WB2CBA/ADX-POCKET/ADX POCKET SCHEMATIC and PCB Layouts/ADX POCKET RF PCB COMPONENT LAYOUT.jpg

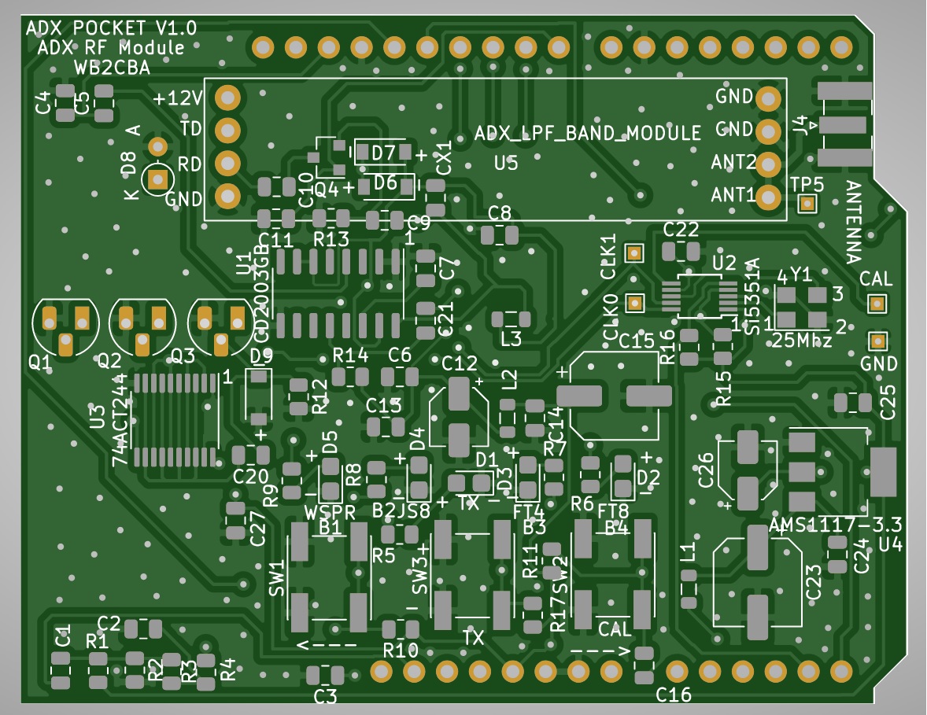
ADX POCKET SCHEMATIC and PCB Layouts/ADX POCKET RF PCB COMPONENT LAYOUT.jpg
