WB2CBA/ADX-POCKET/ADX POCKET SCHEMATIC and PCB Layouts/ADX POCKET CONTROLLER PCB COMPONENT SIDE LAYOUT.jpg

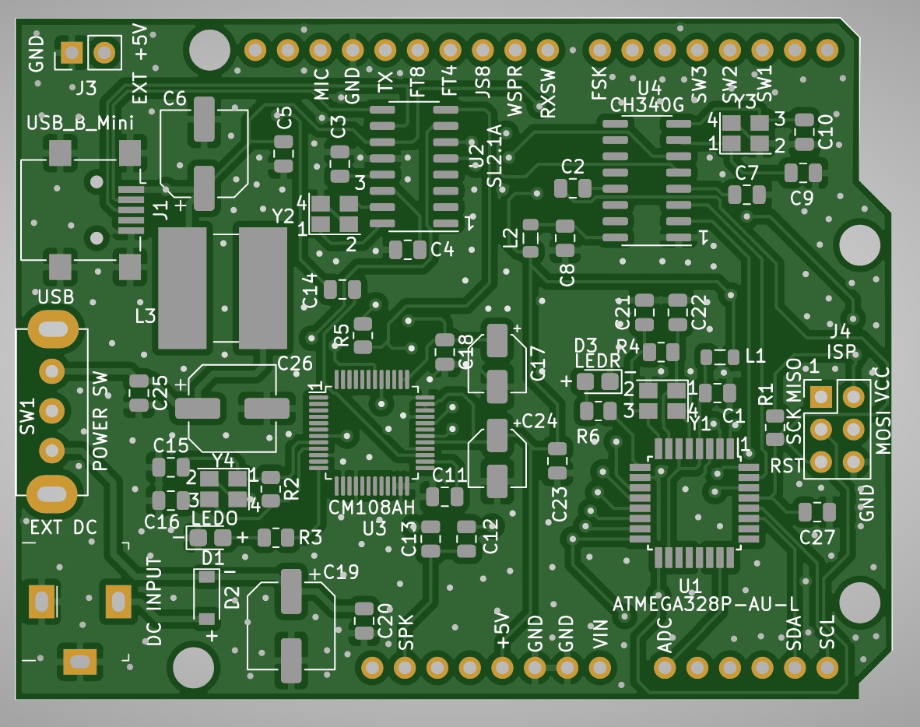
ADX POCKET SCHEMATIC and PCB Layouts/ADX POCKET CONTROLLER PCB COMPONENT SIDE LAYOUT.jpg
