WB2CBA/ADX-POCKET/ADX POCKET SCHEMATIC and PCB Layouts/ADX POCKET BOTTOM PLATE.jpg

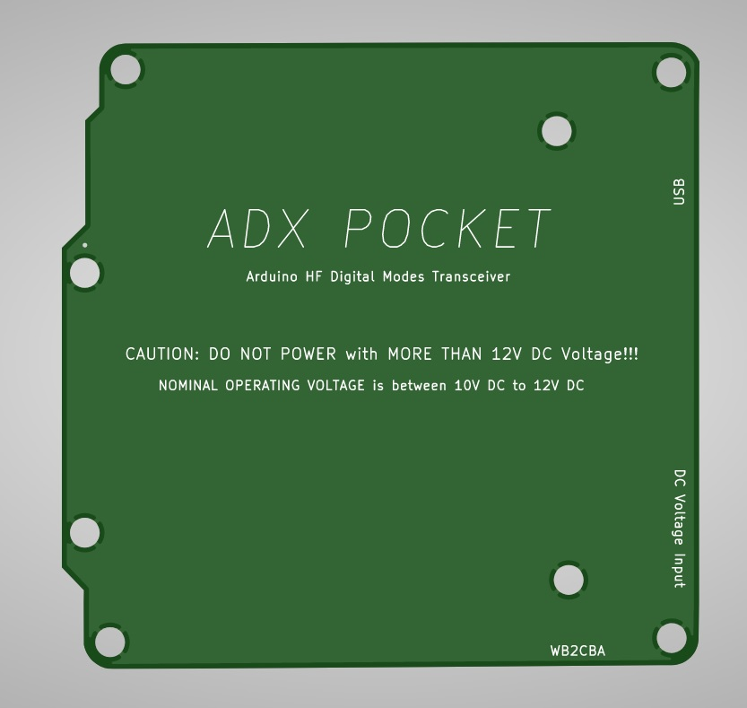
ADX POCKET SCHEMATIC and PCB Layouts/ADX POCKET BOTTOM PLATE.jpg
