WB2CBA/ADX-POCKET/ADX POCKET SCHEMATIC and PCB Layouts/ADX POCKET TOP PLATE.jpg

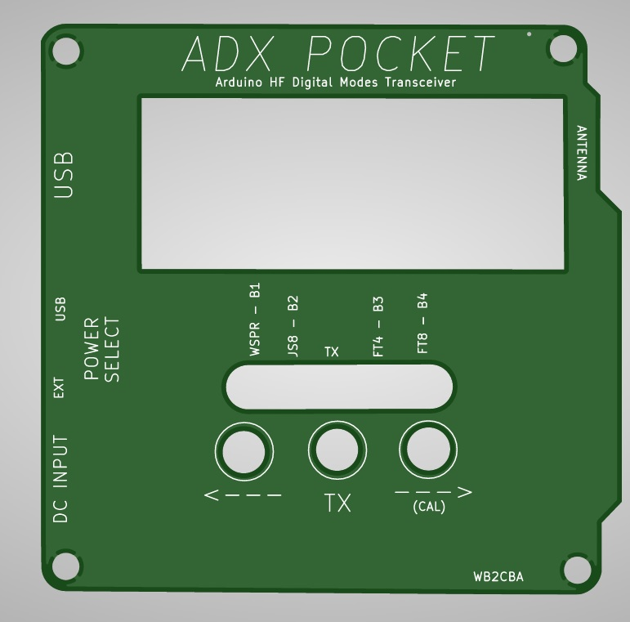
ADX POCKET SCHEMATIC and PCB Layouts/ADX POCKET TOP PLATE.jpg
