WB2CBA/ADX-POCKET/ADX POCKET SCHEMATIC and PCB Layouts/ADX POCKET CONTROLLER BOARD SCHEMATIC.pdf

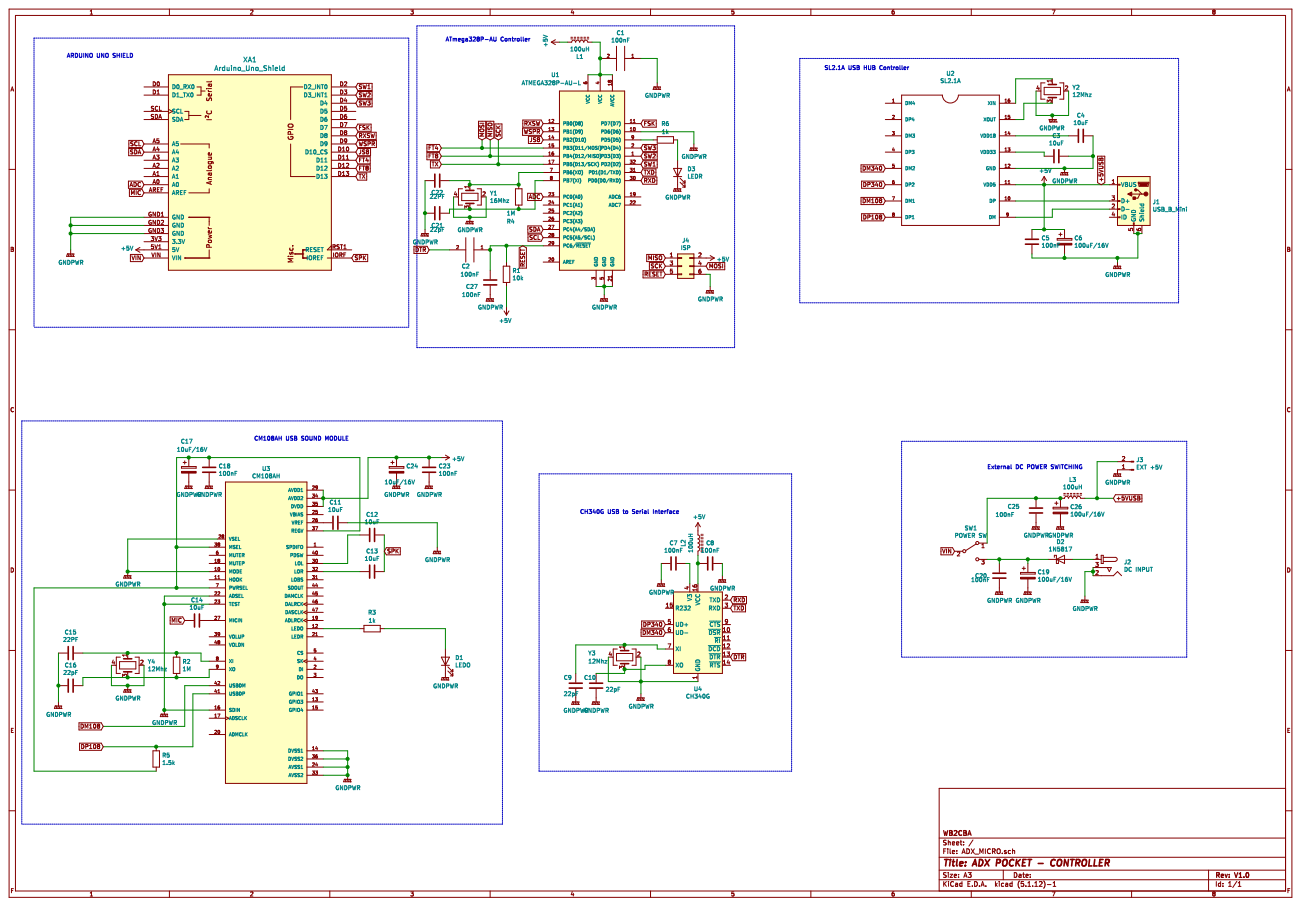
[picture p5: page 1]
