WB2CBA/ADX-POCKET/ADX POCKET SCHEMATIC and PCB Layouts/ADX POCKET RF Transceiver BOARD SCHEMATIC.pdf

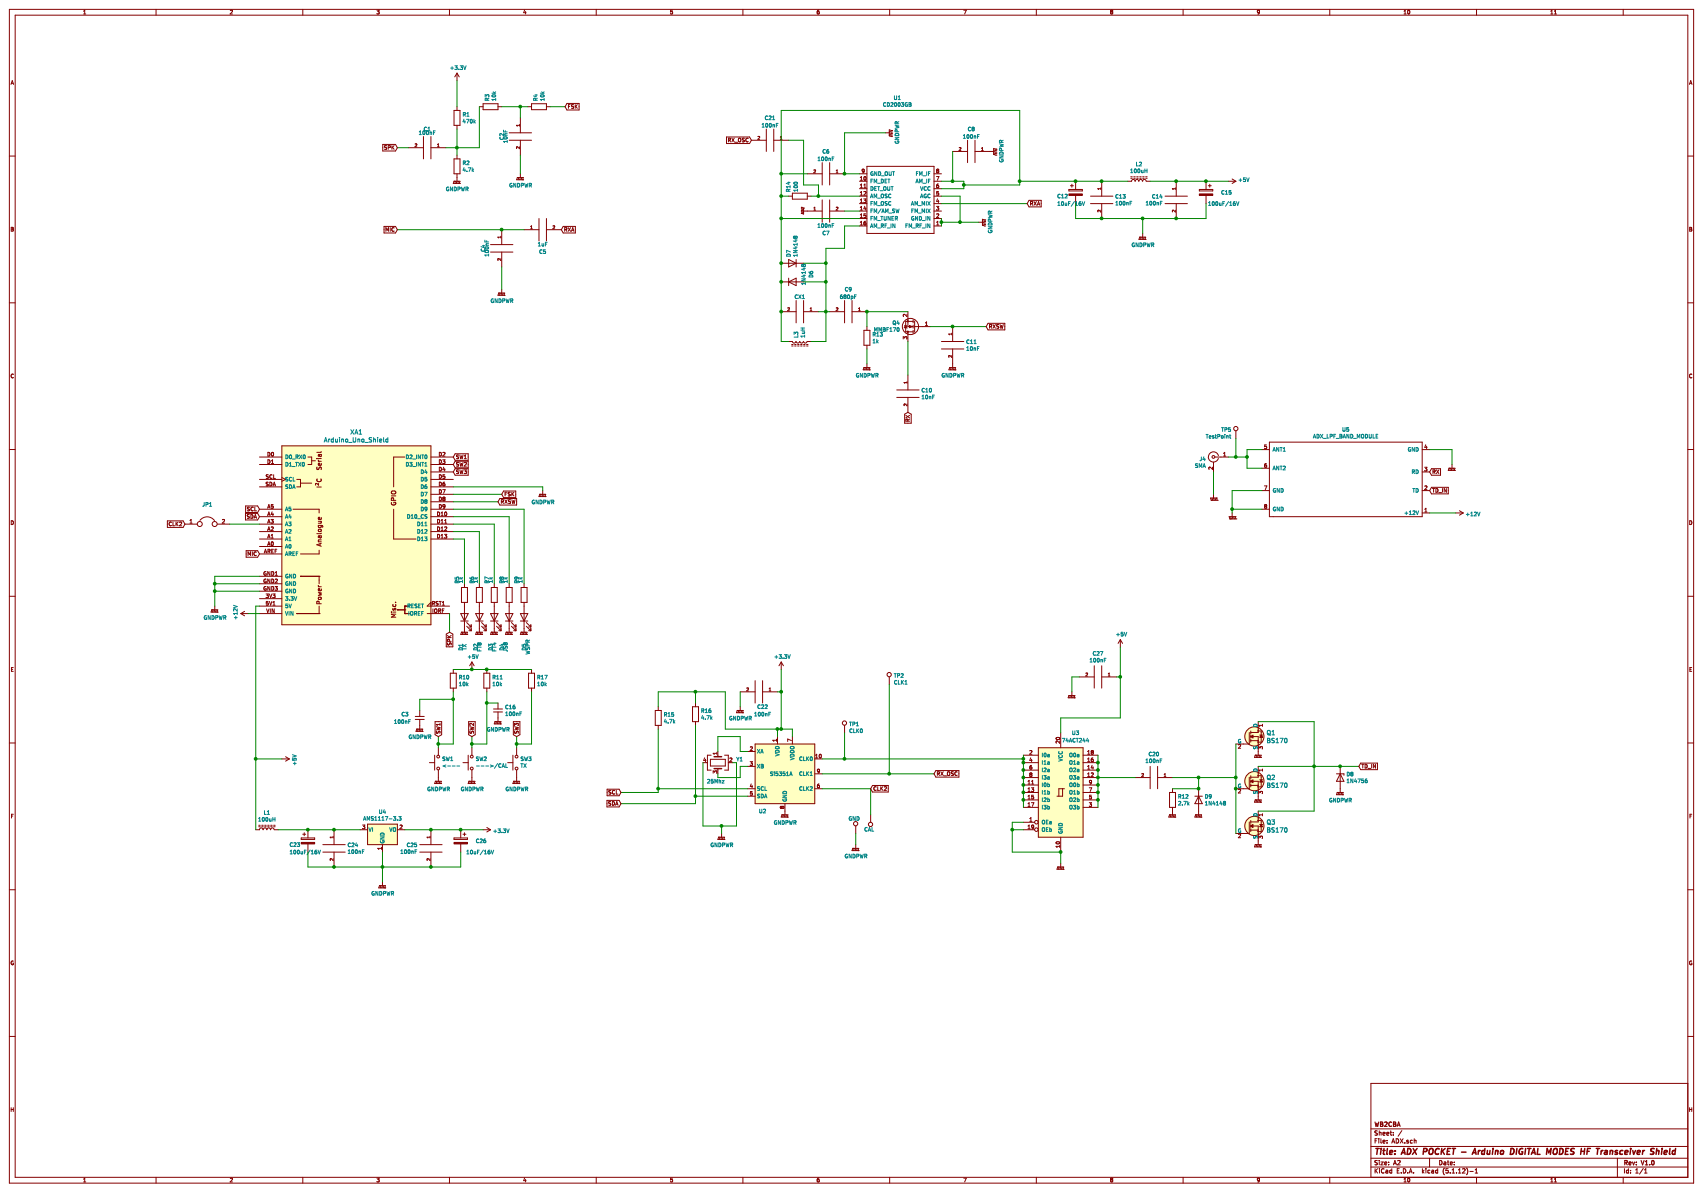
[picture p6: page 1]
