WB2CBA/ADX-POCKET/ADX POCKET FIRMWARE/ADX_POCKET_V1.0.ino

//*********************************************************************************************************
//******************* ADX POCKET - ARDUINO DIGITAL MODES HF TRANSCEIVER WITH CAT CONTROL  ***********************
//********************************* Write up start: 02/01/2022 ********************************************
// FW VERSION: ADX_POCKET_V1.0 - Version release date: 06/26/2023
// Barb(Barbaros ASUROGLU) - WB2CBA - 2022
//*********************************************************************************************************
// Required Libraries
// ----------------------------------------------------------------------------------------------------------------------
// Etherkit Si5351 (Needs to be installed via Library Manager to arduino ide) - SI5351 Library by Jason Mildrum (NT7S) - https://github.com/etherkit/Si5351Arduino
//*****************************************************************************************************
//* IMPORTANT NOTE: Use V2.1.3 of NT7S SI5351 Library. This is the only version compatible with ADX!!!*
//*****************************************************************************************************
// Arduino "Wire.h" I2C library(built-into arduino ide)
// Arduino "EEPROM.h" EEPROM Library(built-into arduino ide)
//*************************************[ LICENCE and CREDITS ]*********************************************
//  Initial FSK TX Signal Generation code by: Burkhard Kainka(DK7JD) - http://elektronik-labor.de/HF/SDRtxFSK2.html
//  SI5351 Library by Jason Mildrum (NT7S) - https://github.com/etherkit/Si5351Arduino
//  ADX CAT code inspired from Lajos Höss, HA8HL TS2000 CAT implementation for Arduino.
//  Improved FSK TX  signal generation code is from JE1RAV https://github.com/je1rav/QP-7C
//
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
//*****************[ SI5351 VFO CALIBRATION PROCEDURE ]****************************************
// For SI5351 VFO Calibration Procedure follow these steps:
// 1 - Connect CAL test point and GND test point on ADX PCB to a Frequency meter or Scope that can measure 1 Mhz up to 1Hz accurately.
// 2 - Press SW2 / --->(CAL) pushbutton and hold.
// 4-  Power up with 12V or with 5V by using arduino USB socket while still pressing SW2 / --->(CAL) pushbutton. 
// 5 - FT8 and WSPR LEDs will flash 3 times and stay lit. Now Release SW2 / --->(CAL). Now Calibration mode is active.
// 6 - Using SW1(<---) and SW2(--->) pushbuttons change the Calibration frequency.
// 7 - Try to read 1 Mhz = 1000000 Hz exact on  Frequency counter or Oscilloscope. 
//     The waveform is Square wave so freqency calculation can be performed esaily.
// 8 - If you read as accurate as possible 1000000 Hz then calibration is done. 
// 9 - Now we must save this calibration value to EEPROM location. 
//     In order to save calibration value, press TX button briefly. TX LED will flash 3 times which indicates that Calibration value is saved.
// 10- Power off ADX.
//
//
//********************************[ CAT CONTROL SETTINGS and CAT Functionality ]********************
// CAT CONTROL RIG EMULATION: KENWOOD TS2000
// SERIAL PORT SETTINGS: 115200 baud,8 bit,1 stop bit
// When CAT is active FT4 and JS8 leds will be solid lit.
// In CAT mode none of the Switches and leds are active including TX SWITCH in order to avoid different setting clashes except TX LED. 
// TX LED WILL BE LIT briefly on/off and then solid during TX WHEN TRANSMITTING IN CAT Mode.
// In CAT mode ADX can be controlled ONLY by CAT interface. Frequency and TX can be controlled via CAT.
// To get out of CAT mode and to use ADX with Switch and led interface just recycle power. Once activated CAT mode stays active as rig control Until power recycle. 
// In CAT mode manual Band setup is deactivated and ADX can be operated on any band as long as the right lpf filter module is plugged in. 
// IN CAT MODE MAKE SURE THE CORRECT LPF MODULE IS PLUGGED IN WHEN OPERATING BAND IS CHANGED!!! IF WRONG LPF FILTER MODULE IS PLUGGED IN then PA POWER MOSFETS CAN BE DAMAGED!
  
//*******************************[ LIBRARIES ]*************************************************
#include <si5351.h>
#include "Wire.h"
#include <EEPROM.h>
//*******************************[ VARIABLE DECLERATIONS ]*************************************
uint32_t val;
int temp;
uint32_t val_EE; 
int addr = 0;
int mode;
//unsigned long freq; 
unsigned long int freq1;
unsigned long int freq =  14074000;
int32_t cal_factor;
int TX_State = 0;

unsigned long Cal_freq = 1000000UL; // Calibration Frequency: 1 Mhz = 1000000 Hz
unsigned long F_FT8;
unsigned long F_FT4; 
unsigned long F_JS8;
unsigned long F_WSPR;
int Band_slot;
int Band = 0;
int UP_State;
int DOWN_State;
int TXSW_State;
int Bdly = 250;

//------------ CAT Variables
int cat_stat = 0;
int CAT_mode = 2;   
String received;
String receivedPart1;
String receivedPart2;    
String command;
String command2;  
String parameter;
String parameter2; 
String sent;
String sent2;
int TxStatus = 0; //0 =  RX 1=TX

// **********************************[ DEFINE's ]***********************************************
#define UP 2    // UP Switch
#define DOWN 3  // DOWN Switch
#define TXSW 4  // TX Switch

#define TX 13 //TX LED
#define WSPR  9 //WSPR LED 
#define JS8  10 //JS8 LED
#define FT4  11 //FT4 LED
#define FT8 12 //FT8 LED
#define RX  8 // RX SWITCH
#define SI5351_REF 		25000000UL  //change this to the frequency of the crystal on your si5351’s PCB, usually 25 or 27 MHz

//**********************************[ BAND SELECT ]************************************************
// ADX can support up to 4 bands on board. Those 4 bands needs to be assigned to Band1 ... Band4 from supported 8 bands.
// To change bands press SW1 and SW2 simultaneously. Band LED will flash 3 times briefly and stay lit for the stored band. also TX LED will be lit to indicate
// that Band select mode is active. Now change band bank by pressing SW1(<---) or SW2(--->). When desired band bank is selected press TX button briefly to exit band select mode. 
// Now the new selected band bank will flash 3 times and then stored mode LED will be lit. 
// TX won't activate when changing bands so don't worry on pressing TX button when changing bands in band mode.

// Assign your prefered bands to B1,B2,B3 and B4
// Supported Bands are: 80m, 40m, 30m, 20m,17m, 15m, 10m

int Band1 = 40; // Band 1 // These are default bands. Feel free to swap with yours
int Band2 = 30; // Band 2
int Band3 = 20; // Band 3
int Band4 = 17; // Band 4

//********************************[ CAT CONTROL VARIABLES ] **********************************************



Si5351 si5351;

//*************************************[ SETUP FUNCTION ]************************************** 
void setup()
{
   cat_stat = 0;
   pinMode(UP, INPUT);
   pinMode(DOWN, INPUT);
   pinMode(TXSW, INPUT);
   
pinMode(TX, OUTPUT);
pinMode(WSPR, OUTPUT);
pinMode(JS8, OUTPUT);
pinMode(FT4, OUTPUT);
pinMode(FT8, OUTPUT);
pinMode(RX, OUTPUT);

//pinMode(PTT,OUTPUT); // for CAT CONTROL

pinMode(7, INPUT); //PD7 = AN1 = HiZ, PD6 = AN0 = 0

//SET UP SERIAL FOR CAT CONTROL

Serial.begin(9600); 
Serial.setTimeout(4); 
  
INIT();

//------------------------------- SET SI5351 VFO -----------------------------------  
   // The crystal load value needs to match in order to have an accurate calibration
  si5351.init(SI5351_CRYSTAL_LOAD_8PF, 0, 0);
  si5351.set_correction(cal_factor, SI5351_PLL_INPUT_XO);
 si5351.set_pll(SI5351_PLL_FIXED, SI5351_PLLA);
  si5351.drive_strength(SI5351_CLK0, SI5351_DRIVE_8MA);// SET For Max Power
  si5351.drive_strength(SI5351_CLK1, SI5351_DRIVE_2MA); // Set for reduced power for RX 
  
 if ( digitalRead(DOWN) == LOW ) {
Calibration();
 }
 

  TCCR1A = 0x00;
  TCCR1B = 0x01; // Timer1 Timer 16 MHz
  TCCR1B = 0x81; // Timer1 Input Capture Noise Canceller
  ACSR |= (1<<ACIC);  // Analog Comparator Capture Input
  
  pinMode(7, INPUT); //PD7 = AN1 = HiZ, PD6 = AN0 = 0
          digitalWrite(RX,LOW);

 Mode_assign(); 

}
 
//**************************[ END OF SETUP FUNCTION ]************************

//***************************[ Main LOOP Function ]**************************
void loop()
{  

// CAT CHECK SERIAL FOR NEW DATA FROM WSJT-X AND RESPOND TO QUERIES

  
  if (Serial.available() > 0){
   cat_stat = 1; 
        si5351.set_freq(freq * 100ULL, SI5351_CLK1);
        si5351.output_enable(SI5351_CLK1, 1);   //RX on
        digitalWrite(WSPR, LOW); 
             digitalWrite(JS8, HIGH); 
                 digitalWrite(FT4, HIGH); 
                     digitalWrite(FT8, LOW); 
                     
       CAT_control(); 
     
    
  }

       UP_State = digitalRead(UP);
          DOWN_State = digitalRead(DOWN);


if ((UP_State == LOW)&&(DOWN_State == LOW)&&(TX_State == 0)&&(cat_stat == 0)) {
   delay(100); 
 UP_State = digitalRead(UP);
    DOWN_State = digitalRead(DOWN);
if ((UP_State == LOW)&&(DOWN_State == LOW)&&(TX_State == 0)&&(cat_stat == 0)) {

    Band_Select();
    
  }
}

  

if ((UP_State == LOW)&&(DOWN_State == HIGH)&&(TX_State == 0)&&(cat_stat == 0)) {
   delay(50); 
     
UP_State = digitalRead(UP);
if ((UP_State == LOW)&&(DOWN_State == HIGH)&&(TX_State == 0)&&(cat_stat == 0)) {
mode = mode - 1;

if (mode < 1){
mode = 4;
}



addr = 40;
 EEPROM.put(addr, mode); 
                Mode_assign();
                
  }} 
   
      DOWN_State = digitalRead(DOWN);

if ((UP_State == HIGH) && (DOWN_State == LOW)&&(TX_State == 0)&&(cat_stat == 0)) {
   delay(50); 
     
DOWN_State = digitalRead(DOWN);
if ((UP_State == HIGH) && (DOWN_State == LOW)&&(TX_State == 0)&&(cat_stat == 0)) {
mode = mode + 1;

if (mode > 4){
mode = 1;
}



addr = 40;
 EEPROM.put(addr, mode); 
                    Mode_assign();
                    
  }} 

  TXSW_State = digitalRead(TXSW);

if ((TXSW_State == LOW) && (TX_State == 0)&&(cat_stat == 0)) {
   delay(50); 
     
TXSW_State = digitalRead(TXSW);
if ((TXSW_State == LOW) && (TX_State == 0)&&(cat_stat == 0)) {
  
Mode_assign();

ManualTX();

           }
  
     }
  
 unsigned int d1,d2;
 int FSK = 10;
 int FSKtx = 0;
 while (FSK>0){
  TCNT1 = 0;
  while (ACSR &(1<<ACO)){
    if (TCNT1>65000) {break;
  }
  }  while ((ACSR &(1<<ACO))==0){
    if (TCNT1>65000) {break;}
  }
  TCNT1 = 0;
  while (ACSR &(1<<ACO)){
    if (TCNT1>65000) {break;}
  }
  d1 = ICR1;  
  while ((ACSR &(1<<ACO))==0){
    if (TCNT1>65000) {break;}
  } 
  while (ACSR &(1<<ACO)){
    if (TCNT1>65000) {break;}
  }
  d2 = ICR1;
  if (TCNT1 < 65000){
  unsigned long codefreq = 1600000000/(d2-d1);
    if (codefreq < 350000){
      if (FSKtx == 0){
        TX_State = 1;
          digitalWrite(TX,HIGH);
          digitalWrite(RX,LOW);
         
          si5351.output_enable(SI5351_CLK1, 0);   //RX off
          si5351.output_enable(SI5351_CLK0, 1);   // TX on
      }
      si5351.set_freq((freq * 100 + codefreq), SI5351_CLK0);  
       if(Serial.available() > 0) CAT_control(); 
      FSKtx = 1;
      
    }
  }
  else{
    FSK--;
  }
 }
  digitalWrite(TX,0);
  
       si5351.output_enable(SI5351_CLK0, 0);   //TX off
           si5351.set_freq(freq*100ULL, SI5351_CLK1);
                si5351.output_enable(SI5351_CLK1, 1);   //RX on
    TX_State = 0;
    digitalWrite(RX,HIGH);
  FSKtx = 0;

     
}
//*********************[ END OF MAIN LOOP FUNCTION ]*************************

//********************************************************************************
//******************************** [ FUNCTIONS ] *********************************
//********************************************************************************

//*****************************[ CAT CONTROL FUNCTION ]***************************

void CAT_control(void)
{     
   
                     
    received = Serial.readString();  
    received.toUpperCase();  
    received.replace("\n","");  

           String data = "";
           int bufferIndex = 0;

          for (int i = 0; i < received.length(); ++i)
               {
               char c = received[i];
    
                 if (c != ';')
                    {
                    data += c;
                    }
                 else
                    {
                        if (bufferIndex == 0)
                          {  
                              data += '\0';
                              receivedPart1 = data;
                              bufferIndex++;
                              data = "";
                          }
                         else
                          {  
                              data += '\0';
                              receivedPart2 = data;
                              bufferIndex++;
                              data = "";
                          }
                    }

               }
    
    command = receivedPart1.substring(0,2);
    command2 = receivedPart2.substring(0,2);    
    parameter = receivedPart1.substring(2,receivedPart1.length());
    parameter2 = receivedPart2.substring(2,receivedPart2.length());

    if (command == "FA")  
    {  
        
          if (parameter != "")  
              {  
              freq = parameter.toInt();
              //VfoRx = VfoTx;   
              }
          
          sent = "FA" // Return 11 digit frequency in Hz.  
          + String("00000000000").substring(0,11-(String(freq).length()))   
          + String(freq) + ";";     
    }

    else if (command == "PS")  
        {  
        sent = "PS1;";
        }

    else if (command == "TX")  
        {   
        sent = "TX0;";
        //VfoTx = freq;
        digitalWrite(13,1);
        TxStatus = 1;
       
        }

    else if (command == "RX")  
        {  
        sent = "RX0;";
        //VfoRx = freq;
        digitalWrite(13,0);
        TxStatus = 0;
        
        }

    else  if (command == "ID")  
        {  
        sent = "ID019;";
        }

    else if (command == "AI")  
        {
        sent = "AI0;"; 
        }

    else if (command == "IF")  
        {
          if (TxStatus == 1)
            {  
            sent = "IF" // Return 11 digit frequency in Hz.  
            + String("00000000000").substring(0,11-(String(freq).length()))   
            //+ String(freq) + String("     ") + "+" + "0000" + "0" + "0" + "0" + "00" + "0" + String(CAT_mode) + "0" + "0" + "0" + "0" + "00" + String(" ") + ";"; 
            + String(freq) + "00000" + "+" + "0000" + "0" + "0" + "0" + "00" + "1" + String(CAT_mode) + "0" + "0" + "0" + "0" + "000" + ";"; 
            } 
             else
            {  
            sent = "IF" // Return 11 digit frequency in Hz.  
            + String("00000000000").substring(0,11-(String(freq).length()))   
            //+ String(freq) + String("     ") + "+" + "0000" + "0" + "0" + "0" + "00" + "0" + String(CAT_mode) + "0" + "0" + "0" + "0" + "00" + String(" ") + ";"; 
            + String(freq) + "00000" + "+" + "0000" + "0" + "0" + "0" + "00" + "0" + String(CAT_mode) + "0" + "0" + "0" + "0" + "000" + ";"; 
            } 
       }
  
    else if (command == "MD")  
      {  
      sent = "MD2;";
      }

//------------------------------------------------------------------------------      

    if (command2 == "ID")  
        {  
        sent2 = "ID019;";
        }
            
    if (bufferIndex == 2)
        {
        Serial.print(sent2);
        }
        
    else
    {
        Serial.print(sent);
    }  

   if ((command == "RX") or (command = "TX")) delay(50);

    sent = String("");
    sent2 = String("");  
}

//********************************[ MODE Assign ]**********************************

void Mode_assign(){
  
addr = 40;
EEPROM.get(addr,mode);


if ( mode == 1){
  freq1 = F_WSPR;
 digitalWrite(WSPR, HIGH); 
     digitalWrite(JS8, LOW); 
         digitalWrite(FT4, LOW); 
             digitalWrite(FT8, LOW); 

}

if ( mode == 2){
  freq1 = F_JS8;
digitalWrite(WSPR, LOW); 
     digitalWrite(JS8, HIGH); 
         digitalWrite(FT4, LOW); 
             digitalWrite(FT8, LOW); 


  
}

if ( mode == 3){
  freq1 = F_FT4;

digitalWrite(WSPR, LOW); 
     digitalWrite(JS8, LOW); 
         digitalWrite(FT4, HIGH); 
             digitalWrite(FT8, LOW); 

  
}
if ( mode == 4){
  freq1 = F_FT8;
  
digitalWrite(WSPR, LOW); 
     digitalWrite(JS8, LOW); 
         digitalWrite(FT4, LOW); 
             digitalWrite(FT8, HIGH); 

  
}
freq = freq1; 
//freq = freq1 - 1000;

}

//********************************[ END OF MODE ASSIGN ]*******************************

//*********************[ Band dependent Frequency Assign Function ]********************
void Freq_assign(){


//---------- 80m/3.5Mhz 
          if (Band == 80){

            F_FT8 = 3573000;
            F_FT4 = 3575000;
            F_JS8 = 3578000;
            F_WSPR = 3568600;
          }

//---------- 40m/7 Mhz 
          if (Band == 40){

            F_FT8 = 7074000;
            F_FT4 = 7047500;
            F_JS8 = 7078000;
            F_WSPR = 7038600;
          }


//---------- 30m/10 Mhz 
          if (Band == 30){

            F_FT8 = 10136000;
            F_FT4 = 10140000;
            F_JS8 = 10130000;
            F_WSPR = 10138700;
          }


//---------- 20m/14 Mhz 
          if (Band == 20){

            F_FT8 = 14074000;
            F_FT4 = 14080000;
            F_JS8 = 14078000;
            F_WSPR = 14095600;
          }


 //---------- 17m/18 Mhz 
          if (Band == 17){

            F_FT8 = 18100000;
            F_FT4 = 18104000;
            F_JS8 = 18104000;
            F_WSPR = 18104600;
          } 

//---------- 15m/ 21Mhz 
          if (Band == 15){

            F_FT8 = 21074000;
            F_FT4 = 21140000;
            F_JS8 = 21078000;
            F_WSPR = 21094600;
          } 
          
//---------- 10m/ 28Mhz 
          if (Band == 10){

            F_FT8 = 28074000;
            F_FT4 = 28180000;
            F_JS8 = 28078000;
            F_WSPR = 28124600;
          }
                     
}
//************************[ End of Frequency assign function ]*************************  

//******************************[ Band  Assign Function ]******************************

void Band_assign(){
digitalWrite(WSPR, LOW); 
     digitalWrite(JS8, LOW); 
         digitalWrite(FT4, LOW); 
             digitalWrite(FT8, LOW); 


addr = 50;
EEPROM.get(addr,Band_slot);

if (Band_slot == 1){
  Band = Band1;
  
digitalWrite(WSPR, HIGH); 
delay(Bdly);
digitalWrite(WSPR, LOW); 
delay(Bdly);
digitalWrite(WSPR, HIGH); 
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
Band_slot = Band_slot + 1;

if (Band_slot > 4){
Band_slot = 1;
       }
    }
 }
                                                

TX_State = digitalRead(TXSW);

if (TX_State == LOW) {
   delay(100); 
 
    TX_State = digitalRead(TXSW);
if (TX_State == LOW) {
  
digitalWrite(TX,0); 

   goto Band_exit;
    
  }
} 

goto Band_cont;

Band_exit:

addr = 50;
 EEPROM.put(addr, Band_slot); 


 Band_assign();


}
  
//*********************************[ END OF BAND SELECT ]*****************************




//************************** [SI5351 VFO Calibration Function] ************************

void Calibration(){

digitalWrite(FT8, LOW);
digitalWrite(FT4, LOW);
digitalWrite(JS8, LOW);
digitalWrite(WSPR, LOW);

digitalWrite(WSPR, HIGH); 
digitalWrite(FT8, HIGH);
delay(100);        
 
digitalWrite(WSPR, LOW); 
digitalWrite(FT8, LOW);
delay(100);                 


digitalWrite(WSPR, HIGH); 
digitalWrite(FT8, HIGH);
delay(100);        
 
digitalWrite(WSPR, LOW); 
digitalWrite(FT8, LOW);
delay(100);                       

 digitalWrite(WSPR, HIGH); 
digitalWrite(FT8, HIGH);
delay(100);        
 
digitalWrite(WSPR, LOW); 
digitalWrite(FT8, LOW);
delay(100);                       

digitalWrite(WSPR, HIGH); 
digitalWrite(FT8, HIGH);
delay(100);        
 
digitalWrite(WSPR, LOW); 
digitalWrite(FT8, LOW);
delay(100);                       

digitalWrite(WSPR, HIGH); 
digitalWrite(FT8, HIGH);

addr = 10;
EEPROM.get(addr, cal_factor); 

Calibrate:

    UP_State = digitalRead(UP);

if (UP_State == LOW) {
   delay(50); 
     
UP_State = digitalRead(UP);
if (UP_State == LOW) {

cal_factor = cal_factor - 100;

  si5351.set_correction(cal_factor, SI5351_PLL_INPUT_XO);
  
  
  // Set CLK2 output
  si5351.set_freq(Cal_freq * 100, SI5351_CLK2);
  si5351.drive_strength(SI5351_CLK2, SI5351_DRIVE_2MA); // Set for lower power for calibration
  si5351.set_clock_pwr(SI5351_CLK2, 1); // Enable the clock for calibration

  
  }} 
   
    DOWN_State = digitalRead(DOWN);

if (DOWN_State == LOW) {
   delay(50);   
   
         DOWN_State = digitalRead(DOWN);
if (DOWN_State == LOW) {

cal_factor = cal_factor + 100;
    
  si5351.set_correction(cal_factor, SI5351_PLL_INPUT_XO);
  
  // Set CLK2 output
  si5351.set_freq(Cal_freq * 100, SI5351_CLK2);
  si5351.drive_strength(SI5351_CLK2, SI5351_DRIVE_2MA); // Set for lower power for Calibration
  si5351.set_clock_pwr(SI5351_CLK2, 1); // Enable clock2 

  }}

    TXSW_State = digitalRead(TXSW);

if (TXSW_State == LOW) {
   delay(50);   
   
         TXSW_State = digitalRead(TXSW);
if (TXSW_State == LOW) {
  
addr = 10;
EEPROM.put(addr, cal_factor); 

digitalWrite(TX, HIGH); 
delay(Bdly);
digitalWrite(TX, LOW); 
delay(Bdly);
digitalWrite(TX, HIGH); 
delay(Bdly);
digitalWrite(TX, LOW); 
delay(Bdly);
digitalWrite(TX, HIGH); 
delay(Bdly);
digitalWrite(TX, LOW); 

    
  }} 

   goto Calibrate;
      }

//****************************** [ End Of Calibration Function ]****************************************

//*********************************[ INITIALIZATION FUNCTION ]******************************************
void INIT(){

 addr = 30;
EEPROM.get(addr,temp);

if (temp != 100){
  
addr = 10; 
cal_factor = 100000;
EEPROM.put(addr, cal_factor); 

addr = 40;
temp = 4;
EEPROM.put(addr,temp);

addr = 30;
temp = 100;
EEPROM.put(addr,temp);

addr = 50;
temp = 1;
EEPROM.put(addr,temp);

        }

else

{
//--------------- EEPROM INIT VALUES
addr = 30;
EEPROM.get(addr,temp);

addr = 10;
EEPROM.get(addr,cal_factor);

addr = 40;
EEPROM.get(addr,mode);

addr = 50;
EEPROM.get(addr,Band_slot);


    }  

Band_assign();

Freq_assign();

Mode_assign();

 si5351.set_clock_pwr(SI5351_CLK2, 0); // Turn off Calibration Clock

}
//********************************[ END OF INITIALIZATION FUNCTION ]*************************************
